anshverma/MineBot/ReadMe.rtf

This file contains two arduino codes -

1. Feeder : which incorporates the flagging and the feeder mechanism
2. Steering : which incorporates the sensing and guidance feedback to steer the robot in the correct direction

This file also contains the CAD files used for fabricating the feeder mechanism. Also a final report with appendix that gives further technical details about the project.

Ansh Verma - verma25@purdue.edu
Ryan Clark - ryanclark17@gmail.com
Tyler Hlemus - thelmus@purdue.edu
Jiajun Cao - jjcao@purdu.edu
