anshverma/MineBot/Feeder CAD File/magnettrack.stl

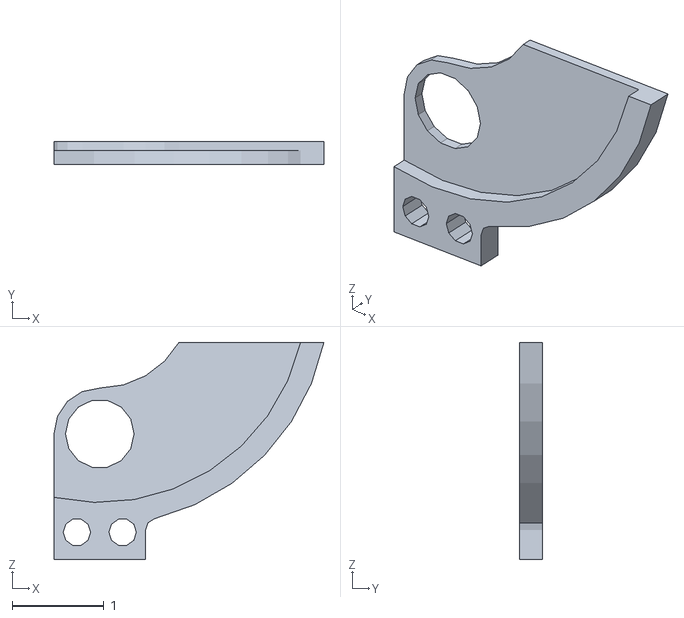
[picture p8: CAD file, 2014-05-03]
Feeder CAD File/magnettrack.stl
2.95 x 0.25 x 2.38
