anshverma/MineBot/Feeder CAD File/servoattachment.stl

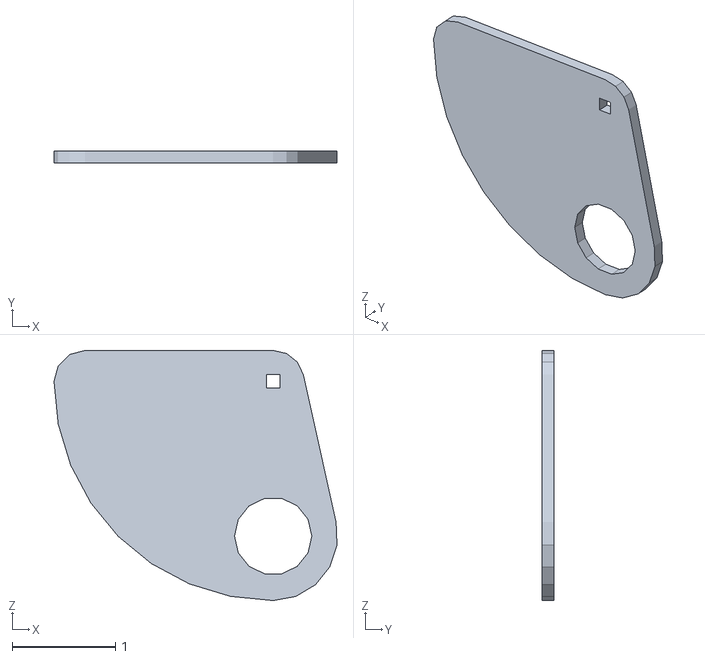
[picture p9: CAD file, 2014-05-03]
Feeder CAD File/servoattachment.stl
2.74 x 0.12 x 2.43
