anshverma/MineBot/Feeder CAD File/mag_tower.stl

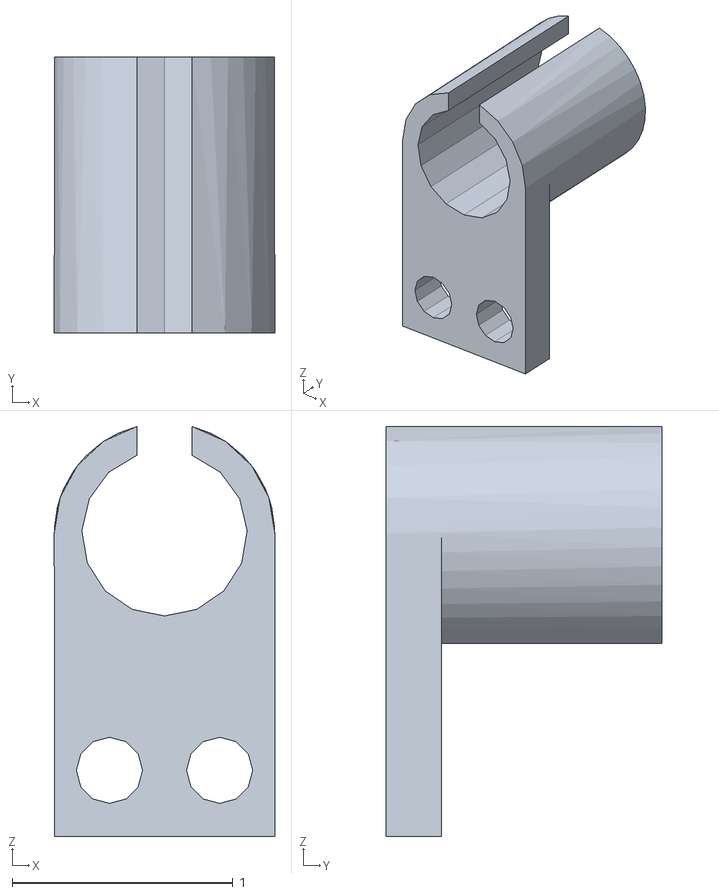
[picture p10: CAD file, 2014-05-03]
Feeder CAD File/mag_tower.stl
1.00 x 1.25 x 1.86
