anshverma/MineBot/(list of files, drawings)

Other design files:
Circuit Diagrams/Flagging Circuit.fzz
Circuit Diagrams/red_bull_combined.fzz
Circuit Diagrams/red_bull_steering.fzz
