anshverma/MineBot/(commit log)

2014-05-03 Initial Codes
    [mag_tower.stl, magnettrack.stl, servoattachment.stl]
2014-05-05 Final Codes
    Final commented project report
    [Flagging Circuit.fzz, red_bull_combined.fzz, red_bull_steering.fzz]
